benleachps4-cloud/sandbar-clock/case/preview/rear.png

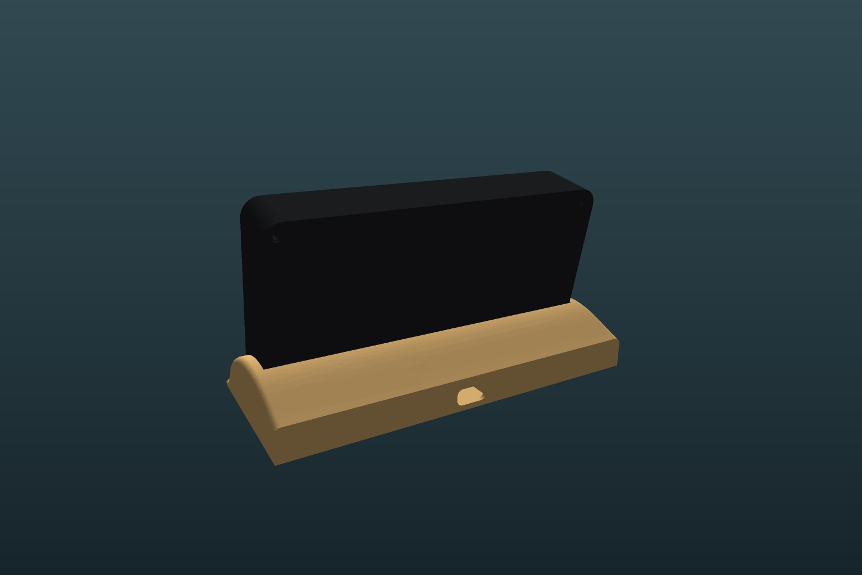
case/preview/rear.png
