benleachps4-cloud/sandbar-clock/case/sandbar_case_parts.step

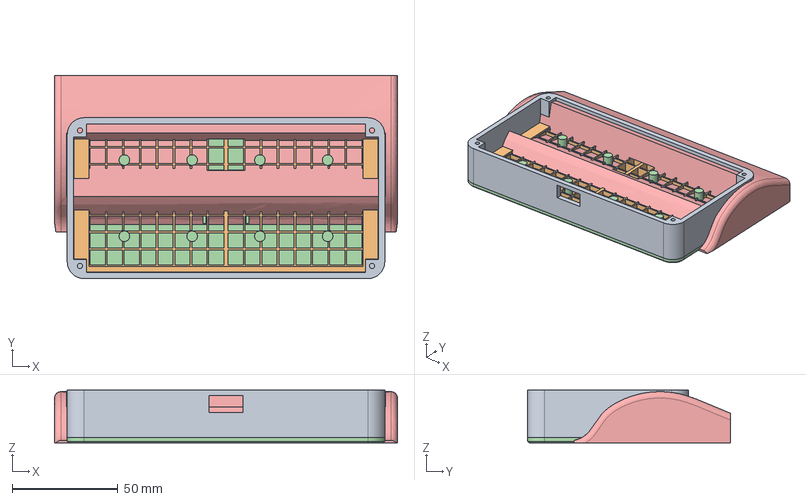
[picture p3: CAD file, 2026-11-08]
case/sandbar_case_parts.step
162.0 x 96.0 x 25.0 mm
