benleachps4-cloud/sandbar-clock/case/stl/3_diffuser_WHITE.stl

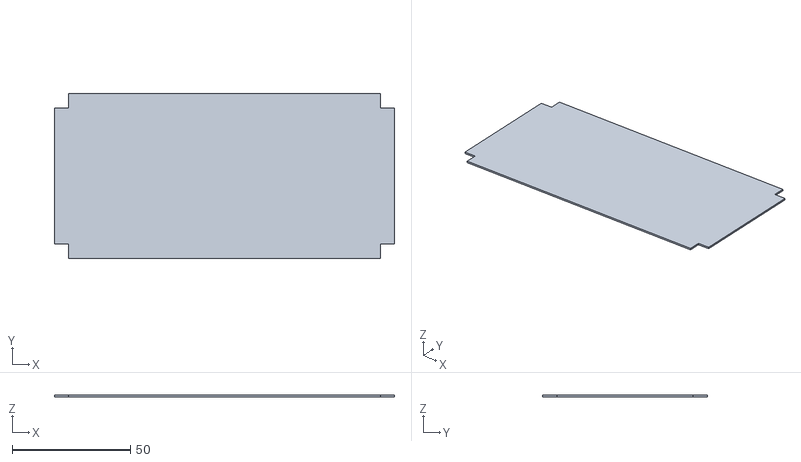
[picture p4: CAD file, 2026-11-08]
case/stl/3_diffuser_WHITE.stl
143.6 x 69.6 x 0.8
