benleachps4-cloud/sandbar-clock/case/stl/2_light_grid.stl

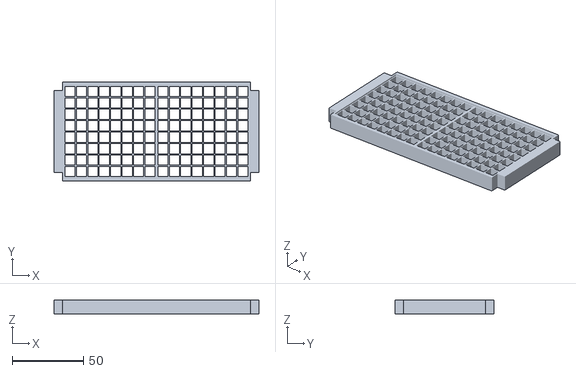
[picture p5: CAD file, 2026-11-08]
case/stl/2_light_grid.stl
143.6 x 69.6 x 10.0
