benleachps4-cloud/sandbar-clock/case/stl/5_dune_base.stl

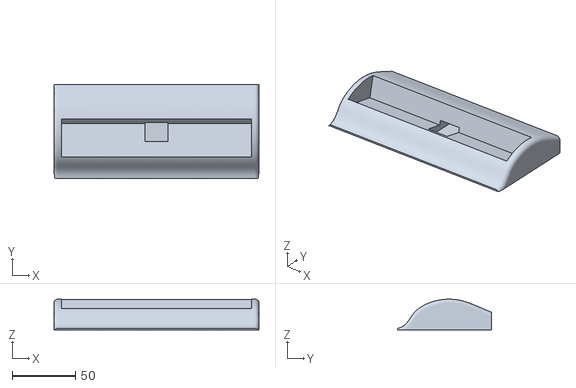
[picture p6: CAD file, 2026-11-08]
case/stl/5_dune_base.stl
162.0 x 74.0 x 24.2
