benleachps4-cloud/sandbar-clock/case/stl/4_rear_lid.stl

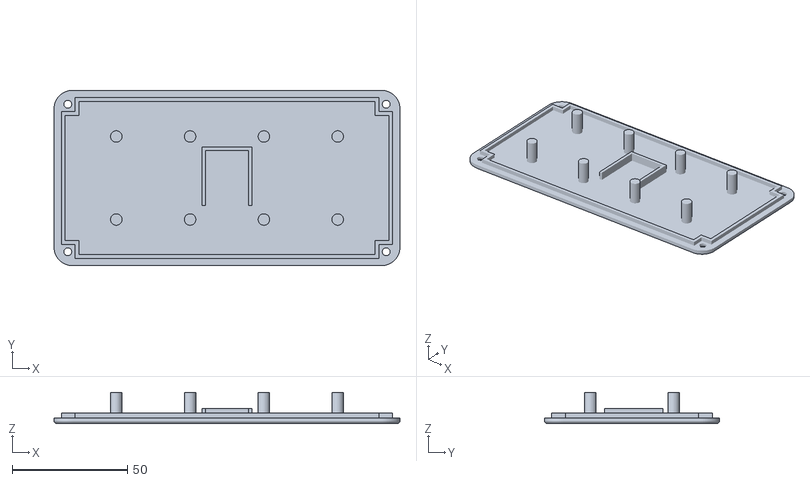
[picture p7: CAD file, 2026-11-08]
case/stl/4_rear_lid.stl
150.0 x 76.0 x 13.5
