benleachps4-cloud/sandbar-clock/case/stl/1_housing.stl

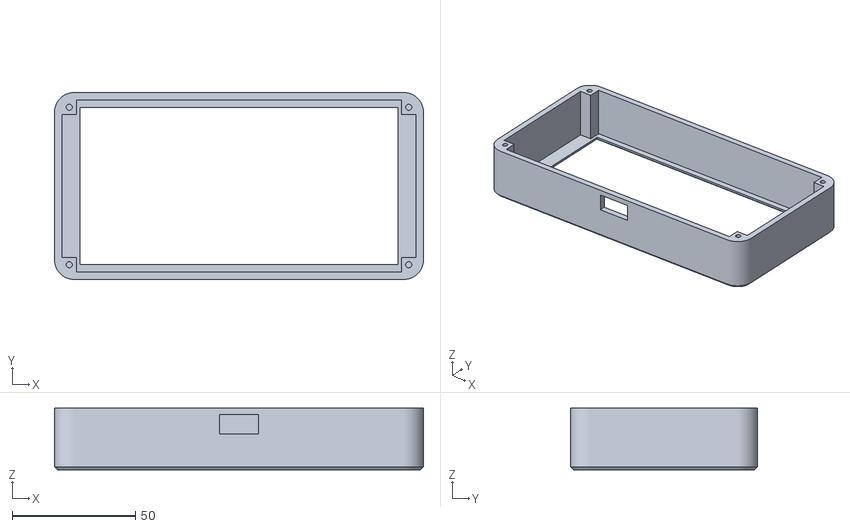
[picture p8: CAD file, 2026-11-08]
case/stl/1_housing.stl
150.0 x 76.0 x 25.0
