benleachps4-cloud/sandbar-clock/case/stl/6_socket_fit_test.stl

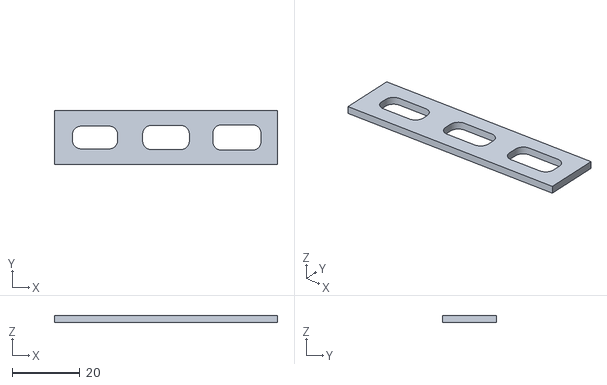
[picture p9: CAD file, 2026-11-08]
case/stl/6_socket_fit_test.stl
66.0 x 16.0 x 2.00
