benleachps4-cloud/sandbar-clock/BUILD_GUIDE.md

# Build your own Sandbar Clock

This guide takes you from a pile of parts to a working clock on your shelf. You'll need basic soldering skills and access to a 3D printer. You don't need to know how to program, and the firmware installs from your web browser.

The finished clock

## What you need

### Electronics

| Qty | Part | Notes |
|---|---|---|
| 2 | 8×8 WS2812B LED panels | Rigid panels, about 65 × 65mm with 8mm between LEDs. The case only fits this size |
| 1 | ESP32-C3 SuperMini | The small board that runs the clock |
| 1 | Snap-in USB-C socket with two wires | 15.5 × 9mm flange and 11mm deep. Any other size needs a different opening in the base |
| 1 | 330Ω resistor | Protects the LED data line |
| 1 | 1000µF capacitor, 10V or higher | Optional, but it protects the LEDs at switch-on |
| 1 | 5V USB power supply, 2A or more | With a USB-A to USB-C cable (see [Troubleshooting](#troubleshooting) about USB-C to USB-C) |
| 4 | M3 countersunk self-tapping screws, 10–12mm | Hold the rear lid on |
| | Thin hook-up wire | 22–26 AWG in at least three colours |

### Tools and materials

- Soldering iron and solder
- Multimeter
- USB-C data cable, to program the board
- 3D printer with a 0.4mm nozzle
- Filament in your choice of colour, plus **white** for the diffuser
- Double-sided foam tape, or a little hot glue

## 1. Print the case

The STL files are in [`case/stl`](case/stl). They're already the right way up for printing, so don't rotate them. The parts are designed to print without supports.

| File | Filament | Notes |
|---|---|---|
| [`1_housing.stl`](case/stl/1_housing.stl) | Your colour | The front shell |
| [`2_light_grid.stl`](case/stl/2_light_grid.stl) | Black or another dark colour | Stops light spreading between LEDs. It has 0.8mm walls, so use a 0.4mm nozzle |
| [`3_diffuser_WHITE.stl`](case/stl/3_diffuser_WHITE.stl) | White | Only 0.8mm thick, so it lets the light through. Print at 0.2mm layers or finer |
| [`4_rear_lid.stl`](case/stl/4_rear_lid.stl) | Your colour | Holds the panels in place and has a cradle for the ESP32 |
| [`5_dune_base.stl`](case/stl/5_dune_base.stl) | Your colour | The stand, which holds the USB-C socket |
| [`6_socket_fit_test.stl`](case/stl/6_socket_fit_test.stl) | Any | A small test plate, described below |

**Print two test parts before the big ones:**

1. Print the light grid and lay it over your two panels, pushed together edge to edge. Every LED should sit inside its own cell.
2. Print the socket test plate and push your USB-C socket into each hole. Printers and sockets vary, and the middle hole is the same size as the one in the base. If a different hole fits better, change `SOCKET_HOLE_W` and `SOCKET_HOLE_H` in [`case/generate_case.py`](case/generate_case.py), which needs FreeCAD to run. The left and right holes are 0.4mm smaller and larger than the middle one.

If your panels have a break-off strip with mounting holes along one edge, remove it. The panels need to sit right up against each other.

## 2. Install the firmware

You'll put the firmware on the board before wiring anything, so that a problem with the board is easy to spot. There's nothing to download, and you only need Chrome or Edge on a computer.

1. Connect the ESP32-C3 to your computer with a USB-C data cable.
2. Open the **[Sandbar Clock Installer](https://benleachps4-cloud.github.io/sandbar-clock/)**.
3. Select **Install Sandbar Clock**, choose your board from the list, then select **Connect**.
4. Follow the prompts. Installing takes about a minute, so leave the board plugged in until it finishes.

If you'd rather compile it yourself or change the code, see [Building from source](#building-from-source).

## 3. Wire it up on the bench

Unplug the board first. Connect everything on your bench before anything goes in the case, and make the wires long enough for the rear lid to lie open next to the housing.

```
                    +-----------------------+
USB-C socket        |                       |
 red   (+5V) --+----+--> 5V   LEFT panel    |
 black (GND) --|-+--+--> GND  (as seen      |
               | |  |    from the front)    |
               | |  |                       |
               | |  |    DIN <---[330R]---- GPIO 4 on ESP32-C3
               | |  |    DOUT --+           |
               | |  +-----------|-----------+
               | |              |
               | |  +-----------|-----------+
               +-|--+--> 5V     |           |
               | +--+--> GND    |  RIGHT    |
               | |  |    DIN <--+  panel    |
               | |  +-----------------------+
               | |
               +-|-----> 5V  on ESP32-C3
                 +-----> GND on ESP32-C3
```

| From | To |
|---|---|
| Socket red (+5V) | 5V on both panels and 5V on the ESP32-C3 |
| Socket black (GND) | GND on both panels and G on the ESP32-C3 |
| GPIO 4 on the ESP32-C3 | 330Ω resistor, then DIN on the left panel |
| DOUT on the left panel | DIN on the right panel |
| Capacitor (optional) | Across 5V and GND where power reaches the panels. The striped leg goes to GND |

- The arrows printed on most panels show which way the data runs, from DIN to DOUT.
- Keep the wires clear of the panel's small components, and keep the joints flat. The rear of the case is about 11mm deep.
- Solder wires straight onto the ESP32-C3 rather than fitting header pins, so it sits flat in its cradle.
- Check the socket with a multimeter before connecting it to anything. Plug it into your power supply and confirm that red is +5V.

> **Use one power source at a time.** Never plug in the ESP32-C3's own USB port and the USB-C socket together, as that connects two supplies to each other. Whenever you're reprogramming, unplug the socket first.

## 4. Check the panel layout

LED panels are wired differently from one maker to the next, so the digits may look scrambled at first. You can fix that from your phone.

1. Lay the panels side by side with the LEDs facing you and the left panel (the one wired to the ESP32) on your left.
2. Power the board from its own USB port. The display may look wrong, which is fine at this stage.
3. On your phone or laptop, join the **Sandbar-Clock-Setup** Wi-Fi network. The password is `sandbar1234`.
4. The clock's page should open by itself. If it doesn't, go to `http://192.168.4.1`.
5. Open **Panel layout**. The clock now shows an orange **L** and a blue **R**.
6. Use the buttons until the L reads correctly on the left panel and the R on the right:

   | What you see | Button |
   |---|---|
   | Letters are jumbled, with rows out of line | **Change row order** |
   | Each letter is on the wrong side | **Swap panels** |
   | A letter is mirrored, upside down or on its side | **Change left panel** or **Change right panel**. There are 8 options, so keep pressing until it reads correctly |

7. Select **Save layout**. The choice stays on the clock, even when it's switched off.

## 5. Put it in the case

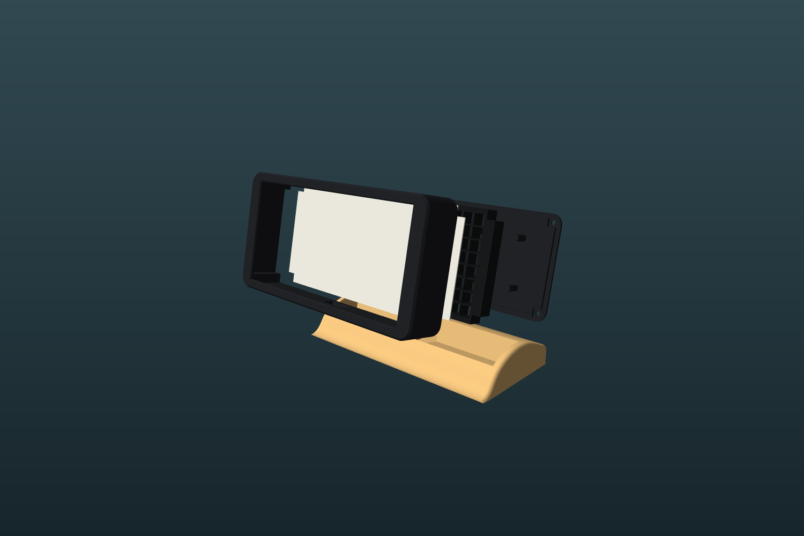
[picture p10: case/preview/exploded.png]
An exploded view of the parts


Work from the back of the housing, with its front face down on a soft cloth. Remember that from this side, the clock's left panel is on your right.

1. **Fit the socket.** Push the socket's wires, then its body, through the opening in the back of the dune base from the outside, until the clips snap in and the flange sits against the wall. The wires come out where the screen will sit.
2. **Drop in the diffuser.** Lay it flat inside the housing, against the window.
3. **Add the light grid.** The flat side goes against the diffuser, and the side with the small pillars faces you.
4. **Add the panels.** Place them LEDs down so that each LED goes into a cell, and push them right together. There should be no gap at the join.
5. **Bring in the power.** Feed the socket's wires through the slot in the bottom wall of the housing, then join them to your 5V and GND wiring. The wires are 105mm long, so extend them if they don't reach. Cover every joint with heat-shrink or tape.
6. **Mount the ESP32-C3.** Fix it in the cradle on the inside of the lid with foam tape, with the USB port towards the cradle's open end. Keep its antenna end clear of the wiring where you can, for a better Wi-Fi signal.
7. **Close the lid.** Check no wires are trapped or sitting under the lid's posts, which press on the back of the panels. Fix the lid with the four M3 screws, stopping as soon as they're snug, because they're cutting into plastic.
8. **Stand it up.** Lower the screen into the slot in the base, feeding the spare wire into the space below it. If it's loose, add a few small dots of glue.

## 6. Connect it to Wi-Fi

1. Plug the USB-C socket into your power supply. With no saved network, the clock shows four dashes and a blue dot.
2. Join the **Sandbar-Clock-Setup** network again, using the password `sandbar1234`.
3. The setup page should open by itself. If it doesn't, go to `http://192.168.4.1`.
4. Under **Wi-Fi and timezone**, choose your network, enter its password and pick your timezone, then save. The network must be 2.4 GHz.

The clock restarts and joins your network. The dot turns green, then the time appears.

## 7. Enjoy your clock

To reach the settings page, go to `http://sandbar-clock.local` from any device on your network. If that doesn't load, use the clock's IP address, which you can find on your router's device list.

- **Clock face:** choose from 64 faces, grouped by category. **Shuffle** picks a new one every hour.
- **Brightness:** drag the slider. The display still dims automatically at night.
- **Location:** enter your latitude and longitude for the Weather window, Real sun and moon, and Tide line faces. The clock fetches this data from Open-Meteo.

The page has no login, so anyone on your home network can change the clock's settings.

## Troubleshooting

| Problem | What to try |
|---|---|
| No LEDs light up | Check the data wire goes to **DIN** rather than DOUT, that all grounds are connected, and that the panels are getting 5V at their pads |
| Only the left panel lights | Check the wire from the left panel's DOUT to the right panel's DIN, and that the right panel has 5V and GND |
| Digits look scrambled | Open **Panel layout** on the clock's page and repeat [step 4](#4-check-the-panel-layout) |
| The installer page says this browser can't install | Use Chrome or Edge on a computer. Firefox, Safari and phones can't connect to USB this way |
| Your board isn't in the installer's list | Try another USB cable, because many only carry power |
| The installer can't connect to the board | Hold **BOOT** on the board, tap **RESET**, release **BOOT**, then try again |
| A USB-C to USB-C charger won't power it | Some sockets lack the resistors these chargers look for. Use a USB-A to USB-C cable |
| The clock can't find the network | It must be 2.4 GHz. The clock opens its setup network again if it can't connect within 20 seconds |
| `sandbar-clock.local` won't open | Some devices don't support `.local` addresses, so use the IP address |
| The LEDs flicker or the board restarts | Use a stronger power supply of at least 5V 2A |

## Going further

- **Using an ESP32-S3:** the installer detects it automatically. Connect the data wire to GPIO 12, and use a board with at least 8MB of flash. On some S3 boards, the `5V` pin isn't connected unless the `IN-OUT` solder jumper is bridged.
- **Updating later:** run the installer again and choose not to erase the board, which keeps your settings. Unplug the USB-C power socket first.
- **Different panels:** change the dimensions at the top of [`case/generate_case.py`](case/generate_case.py) and run it with FreeCAD's `FreeCADCmd` to generate new parts.
- **More about the firmware:** see the [firmware README](firmware/README.md).

## Building from source

You only need this if you want to change the code, such as using a different data pin or your own setup password.

1. Install [Visual Studio Code](https://code.visualstudio.com/), then add the **PlatformIO IDE** extension from its Extensions panel.
2. Download this project with **Code → Download ZIP** on the repository page, then unzip it.
3. In VS Code, choose **File → Open Folder** and select the `firmware` folder.
4. Connect the board and select the **PlatformIO: Upload** arrow in the bottom bar.

The first build downloads several hundred megabytes of tools and can take a good few minutes. It's finished when the terminal shows `SUCCESS`.

| Problem | What to try |
|---|---|
| The build stops with `internal compiler error` | Run the upload again. This error comes and goes |
| Windows blocks the build tools | Smart App Control can stop PlatformIO from running. That's a Windows security setting, so decide for yourself whether to change it, or build on another computer |
